ateachment/UniControlRFM12/UniControlRFM12.pdf

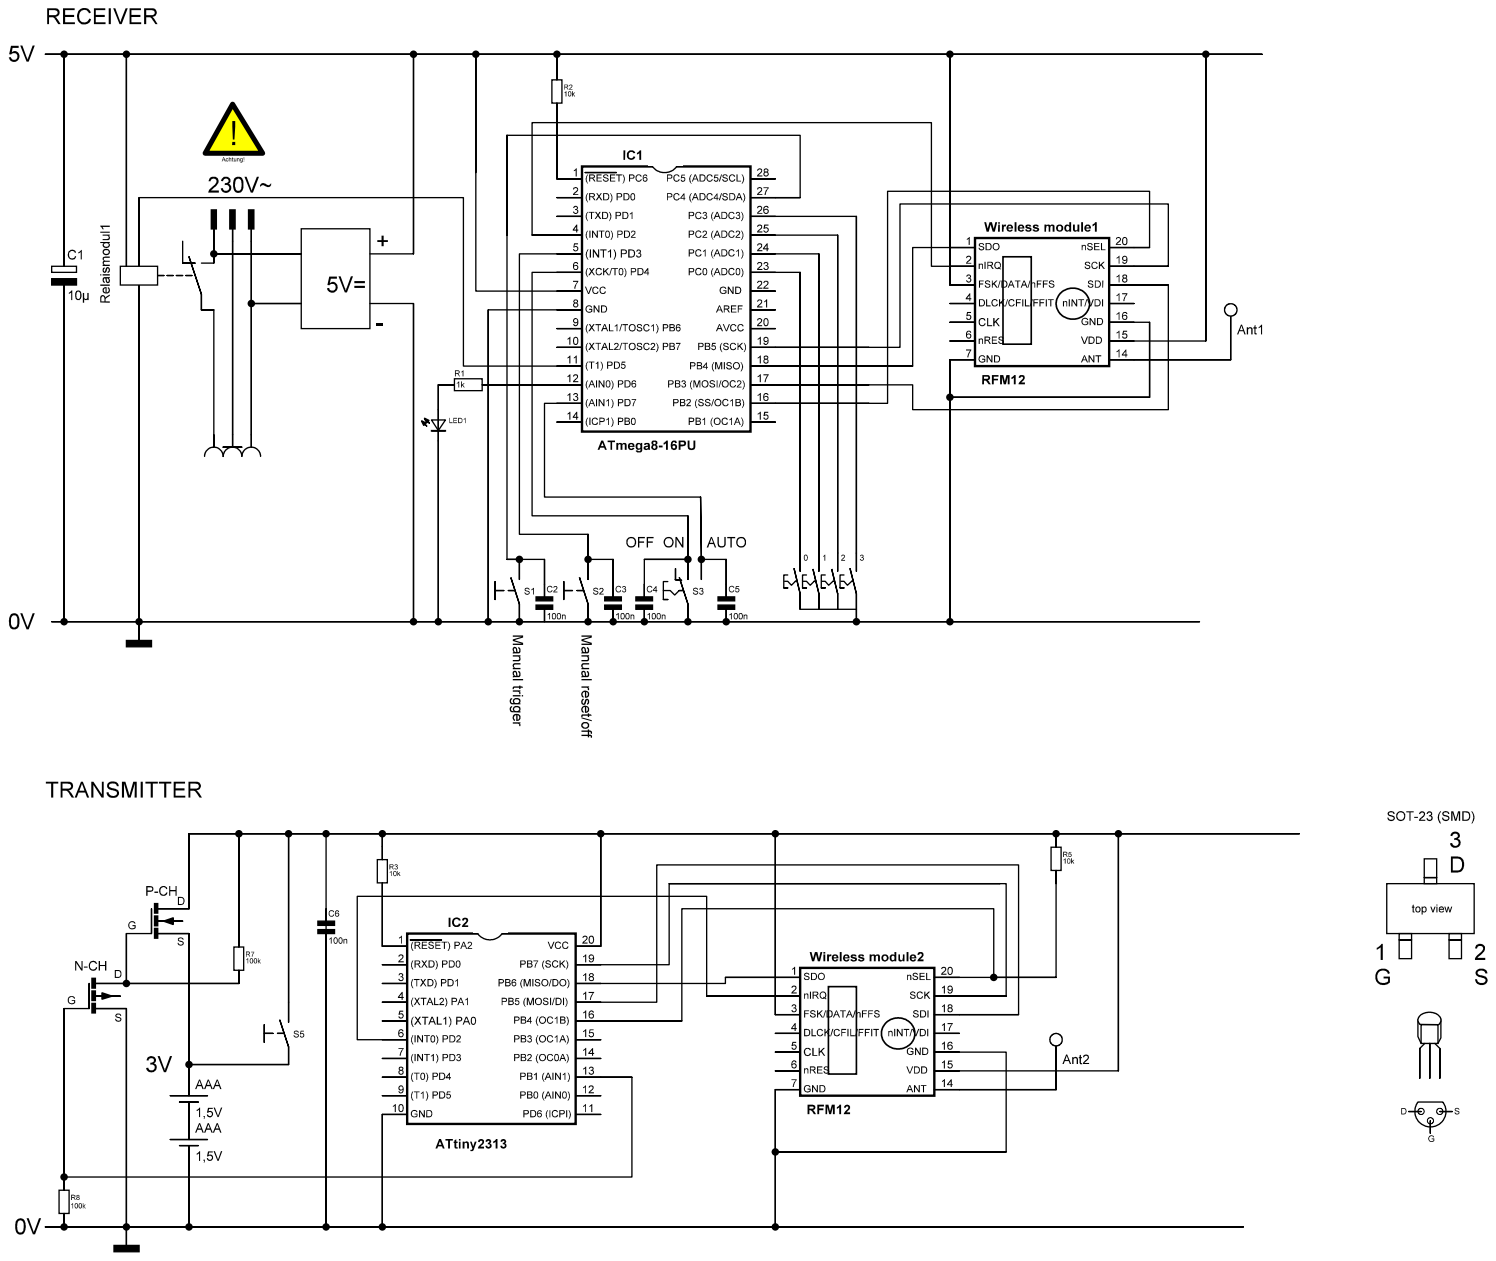
[picture p1: page 1]
