ateachment/UniControlRFM12/(list of files, drawings)

Other design files:
UniControlRFM12.spl7
