ateachment/UniControlRFM12/src/shared/rf12.c

/*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
 * @file        rf12.c
 * @brief
 * @author      Benedikt K.
 * @author      Juergen Eckert
 * @author  	Ulrich Radig (mail@ulrichradig.de) www.ulrichradig.de
 * @author  	Wolfhard Eick (w@eick-at.de) www.eick-at.de
 * @date        18.06.2026 (mit Hilfe von Gemini Flash)
##############################################################################*/


#include <avr/io.h>
#include <avr/interrupt.h>
#include "global.h"
#include "rf12.h"

#ifndef F_CPU
#define F_CPU 8000000UL
#endif

#include <util/delay.h>

#define RF_PORT	PORTB
#define RF_DDR	DDRB
#define RF_PIN	PINB


#if defined(__AVR_ATtiny2313__) || defined(__AVR_ATtiny2313A__)
    // Pins for ATtiny2313 on Pollin-Board v1.2
    #define SDI      5   // PB5 (Connects to RFM12 SDI input -> OUTPUT for Tiny)
    #define SDO      6   // PB6 (Connects to RFM12 SDO output -> INPUT for Tiny)
    #define SCK      7   // PB7 (SPI Clock)
    #define nSEL     4   // PB4 (Chip Select)
#else
    // Pins for ATmega8 on Pollin-Board v1.2 (Hardware SPI)
    #define SDI      3   // PB3 (MOSI)
    #define SDO      4   // PB4 (MISO)
    #define SCK      5   // PB5 (SCK)
    #define nSEL     2   // PB2 (SS)
#endif

// =====================================================================
// GLOBAL VARIABLES
// =====================================================================
volatile unsigned char RF12_Index = 0;
unsigned char RF12_Data[34]; 

#ifdef RF12_INTERRUPT
volatile struct RF12_stati RF12_status;
#endif

unsigned short rf12_trans(unsigned short wert)
{   
    unsigned short werti = 0;
    cbi(RF_PORT, nSEL);     // /SS (slave select to 0)

#ifdef SPI_MODE     // Routine for Hardware SPI (ATmega8)
    SPDR = (0xFF00 & wert) >> 8;      // Assign MSB to data register first
    while(!(SPSR & (1 << SPIF))){};   // Loop until End of Transmission flag is set

    werti = (SPDR << 8);              // Save 1st byte as MSB
    
    SPDR = (0x00ff & wert);           // Assign LSB to data register
    while(!(SPSR & (1 << SPIF))){};   // Wait again (as above)
    werti = werti + SPDR;             // Save 2nd byte as LSB

#else               // Precise Software SPI for ATtiny2313 (Pollin v1.2 Layout)
    unsigned char i;
    
    cbi(RF_PORT, nSEL); 
    cbi(RF_PORT, SCK);  // Ensure Clock starts LOW before the first bit
    _delay_us(5);

    for (i = 0; i < 16; i++)
    {   
        // 1. Present data bit stably on PB5 (SDI) -> goes to RFM12 input
        if (wert & 0x8000)
            sbi(RF_PORT, SDI); 
        else
            cbi(RF_PORT, SDI);
            
        wert <<= 1;
        _delay_us(5); // Setup time for data bit

        // 2. Pull Clock HIGH -> RFM12 samples the data bit
        sbi(RF_PORT, SCK);
        _delay_us(5); // Hold time in HIGH state

        // 3. Sample the incoming data bit from PB6 (SDO) while Clock is still HIGH
        werti <<= 1;
        if (RF_PIN & (1 << SDO)) 
        {
            werti |= 1;
        }

        // 4. Pull Clock LOW again for the next bit
        cbi(RF_PORT, SCK);
        _delay_us(5); // Pause in LOW state
    }
#endif
    sbi(RF_PORT, nSEL);  // Slave Select inactive (HIGH)
    return werti;
}


void rf12_init(void)
{
#if defined(__AVR_ATtiny2313__) || defined(__AVR_ATtiny2313A__)
    // Set PB5 (SDI), PB7 (SCK), PB4 (nSEL) as Output. PB6 (SDO) remains Input.
    RF_DDR = (1 << SDI) | (1 << SCK) | (1 << nSEL);
    // Set nSEL HIGH and enable internal pull-up resistor on PB6 (SDO)
    RF_PORT = (1 << nSEL) | (1 << SDO);
#else
    // ATmega8 initialization
    RF_DDR = (1 << SDI) | (1 << SCK) | (1 << nSEL);
    RF_PORT = (1 << nSEL);
#endif

#ifdef SPI_MODE
    // Enable SPI, Master Mode, Clock Idle LOW, Clock Rate F_CPU / 128
    SPCR = (1 << SPE) | (1 << MSTR) | (1 << SPR0) | (1 << SPR1);
    SPSR &= ~(0 << SPI2X);
#endif

    _delay_ms(100); // Wait for Power-On Reset (POR) to complete

    rf12_trans(0xC0E0);         // AVR CLK output: 10MHz
    rf12_trans(0x80D7);         // Enable FIFO
    rf12_trans(0xC2AB);         // Data Filter: internal
    rf12_trans(0xCA81);         // Set FIFO mode
    rf12_trans(0xE000);         // Disable wakeup timer
    rf12_trans(0xC800);         // Disable low duty cycle
    rf12_trans(0xC4F7);         // AFC settings: autotuning: -10kHz...+7,5kHz
}

void rf12_setbandwidth(unsigned char bandwidth, unsigned char gain, unsigned char drssi)
{
	rf12_trans(0x9400|((bandwidth&7)<<5)|((gain&3)<<3)|(drssi&7));
}

void rf12_setfreq(unsigned short freq)
{	if (freq<96)				// 430,2400MHz
		freq=96;
	else if (freq>3903)			// 439,7575MHz
		freq=3903;
	rf12_trans(0xA000|freq);
}

void rf12_setbaud(unsigned short baud)
{
	if (baud<663)
		return;
	if (baud<5400)					// Baudrate= 344827,58621/(R+1)/(1+nSEL*7)
		rf12_trans(0xC680|((43104/baud)-1));
	else
		rf12_trans(0xC600|((344828UL/baud)-1));
}

void rf12_setpower(unsigned char power, unsigned char mod)
{
	rf12_trans(0x9800|(power&7)|((mod&15)<<4));
}
/*
void rf12_ready(void)
{
	cbi(RF_PORT, nSEL);
	while (!(RF_PIN&(1<<SDO))); // wait until FIFO ready, Beim Tiny horcht MISO am SDI-Pin (PB5)
}
*/

void rf12_ready(void)
{
    cbi(RF_PORT, nSEL);
    uint16_t timeout = 0;
    
    // Schleife läuft NUR, wenn der Pin aktiv auf LOW (0) gezogen wird.
    // Sobald das Modul den Pin freigibt (Pegel steigt auf 3.3V), 
    // ist die Bedingung (== 0) falsch und die Schleife bricht sofort ab.

	// Horcht jetzt korrekt auf PB6 (SDO des Moduls)
    while ((RF_PIN & (1 << SDO)) == 0) 
    {
        timeout++;
        if (timeout > 60000) 
        {
            break; 
        }
    }
}
void rf12_txdata(unsigned char *data)
{	
	RF12_Index = 0;
	rf12_trans(0x8238);			// TX on
	rf12_ready();
	rf12_trans(0xB8AA);
	rf12_ready();
	rf12_trans(0xB8AA);
	rf12_ready();
	rf12_trans(0xB8AA);
	rf12_ready();
	rf12_trans(0xB82D);
	rf12_ready();
	rf12_trans(0xB8D4);
	do 
	{
		rf12_ready();
		rf12_trans(0xB800|(data[RF12_Index++]));
			
	} while ((data[RF12_Index-2] != '\0' || RF12_Index < 2) && RF12_Index < RF12_DataLength+2);
	
	rf12_ready();
	rf12_trans(0x8208);			// TX off
}

void rf12_rxstart(void)
{
    rf12_trans(0x82C8);         // RX on
    rf12_trans(0xCA81);         // set FIFO mode
    rf12_trans(0xCA83);         // enable FIFO
#ifdef RF12_INTERRUPT
    RF12_Index = 0;
    RF12_status.Rx = 1;
    rf12_trans(0x0000);         // Read status / reset IRQ

    // Enable INT0 for ATmega8 or GIMSK for ATtiny2313
#if defined(__AVR_ATtiny2313__) || defined(__AVR_ATtiny2313A__)
    sbi(GIMSK, INT0);           // ATtiny nutzt GIMSK statt GICR!
#else
    sbi(GICR, INT0);            // ATmega8 Register
#endif
    sei();
#endif
}



#ifdef RF12_INTERRUPT
void rf12_rxrestart(void)
{
	if(RF12_status.Rx == 0)         
	{
		rf12_trans(0x82C8);			// RX on
		rf12_trans(0xCA81);			// set FIFO mode
		rf12_trans(0xCA83);			// enable FIFO
		RF12_Index = 0;
		RF12_status.Rx = 1;
#if defined(__AVR_ATtiny2313__) || defined(__AVR_ATtiny2313A__)
        sbi(GIMSK, INT0);
#else
        sbi(GICR, INT0);
#endif
	}
}
#endif


#ifdef RF12_INTERRUPT
ISR(INT0_vect)
{
	if(RF12_status.Rx == 1)  // 
	{
		if(RF12_Index < RF12_DataLength+2)  // Puffer nicht voll
            RF12_Data[RF12_Index++] = rf12_trans(0xB000);
		else	// Puffer voll
		{
			rf12_trans(0x8208); 				//RX off
			RF12_status.Rx = 0;	
#if defined(__AVR_ATtiny2313__) || defined(__AVR_ATtiny2313A__)
            GIMSK &= ~(1<<INT0);
#else				
			GICR &= ~(1<<INT0);		//disable int0
#endif
		}
		//auf EOT pruefen. Achtung Pruefsummenbyte koennte 0 sein
		if(RF12_Data[RF12_Index-1] == '\0' && RF12_Index > 2)		//EOT
		{
			rf12_trans(0x8208);					//RX off
			RF12_status.Rx = 0;
#if defined(__AVR_ATtiny2313__) || defined(__AVR_ATtiny2313A__)
            GIMSK &= ~(1<<INT0);
#else
			GICR &= ~(1<<INT0);		//disable int0
#endif
		}
	}
}
#else  // kein Interrupt
void rf12_rxdata(unsigned char *data, unsigned char number)
{	
	unsigned char i;
	rf12_rxstart();
	for (i=0; i<number; i++)
	{
		rf12_ready();
		*data++=rf12_trans(0xB000);
	}
	rf12_trans(0x8208);			// RX off
}
#endif

uint16_t checksum(unsigned char data[])
{
	uint16_t chksum = 0;
	uint8_t i = 0;
	while(data[i] != '\0' && i < RF12_DataLength)
	{
		chksum += data[i++];
	}
	return chksum;
}
