ateachment/UniControlRFM12/(commit log)

2026-06-18 Use an interrupt to wake up the ATTiny and send data
2026-06-24 double blink of LED2 for error
    [UniControlRFM12.spl7]
2026-06-25 productive transmitting device
2026-07-01 avoid further interrupt until handled
    [UniControlRFM12.spl7]
2026-07-02 continue to take measures to combat radio interference
    [main.c, rf12.c]
2026-07-03 Stabilise the receiver using a FIFO reset
    [main.c]
2026-07-13 Fix power latch circuit
    [UniControlRFM12.spl7]
2026-07-14 change fuse
