ateachment/UniControlRFM12/(notices)

Notices in the files:
src/shared/rf12.c:
Public License as published by the Free Software
